sinara-hw/EEM_PWR_MOD_AC/README.md

# EEM_PWR_MOD_AC
80-264V input range AC power module for EEM

## Design Files

Design files (schematics, PCB layouts, BOMs) can be found at [EEM_PWR_MOD_AC/Releases](https://github.com/sinara-hw/EEM_PWR_MOD_AC/releases).

## Wiki

More information can be found on the [wiki](https://github.com/sinara-hw/EEM_PWR_MOD_AC/wiki).
