sinara-hw/EEM_PWR_MOD_AC/(list of files, drawings)

Other design files:
EEM_PWR_MOD_AC.pcbdoc
EEM_PWR_MOD_AC.PrjPCB
EEM_PWR_MOD_AC.SchDoc
Mechanics.SchDoc
