sinara-hw/EEM_PWR_MOD_AC/(threads)

Thread 1 (2020-12-19):

new power module

gkasprow, 2020-12-19:
The time has come! The power module is simple, low cost and robust. It's based on RPS400-12 power module.
I added load indicator (4 LEDs), EMC filter and metal cover.

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

gkasprow, 2020-12-19:
It's modification of the CPCIS version, with other connector, front panel IEC socket and without all management. The mechanics, PCB shape was already verified.

dtcallcock, 2020-12-31:
Can you add pdfs to v1.0rc1 release @gkasprow if you have time?

gkasprow, 2021-01-05:
done

Closed 2021-08-18.

Thread 2 (2020-12-19):

mechanical BOM

gkasprow, 2020-12-19:
Aapart from mechanic components already in the BOM, several  other components are needed:
- two cables connecting power module and the main board. One siede is Molex KK 2.54, the other side is TKP DH2 (4 pin)
- two cables with M3.5 pan HD screw terminals on both ends
- two M3 screws with washer compatible with 7461057 bushings

kaolpr, 2020-12-22:
* EPP-400-12 MEAN WELL

kaolpr, 2020-12-22:
* AC cable connecting power module and the main board, one side is KK 3.96mm Crimp Terminal Housing (mating with Molex 26-62-4030), the other side is JST VHR

gkasprow, 2020-12-23:
JST VHR can be mated with Molex KK3.96

gkasprow, 2021-02-22:
we need two 4-wire cables terminated with DF11-4DS-2C connectors. Contact PN is DF11-22SCA

gkasprow, 2021-05-27:
the 8HP panels require special 0.1" offset handles, [PN 20817-690](https://schroff.nvent.com/en-gb/products/enc20817-690)

gkasprow, 2021-05-27:
...and the 8HP panel must be [special type](https://schroff.nvent.com/en-gb/products/enc30848-430), compatible with the handle: PN is 30848-430

gkasprow, 2021-05-27:
We of course also need a standard set of components to attach the panel to the PCB: angle bracket plastic sleeves, M2.5 screws, etc.

gkasprow, 2021-08-18:
Front panel part number should be 30848-430 (0,1" offset) with handle 20817-682 (0,1" offset).
For rails 24560-359 (0,1" offset).

https://schroff.nvent.com/en-gb/products/plug-unit-u-profile-front-panel-iel-iet-type-2-01-offset/enc30848-430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
https://schroff.nvent.com/en-gb/products/inserterextractor-handle-type-iel-black-01-offset/enc20817-682
https://schroff.nvent.com/en-gb/products/guide-rail-coding-compactpci-vme64x-offset-01/enc24560-359

Thread 4 (2020-12-30):

Front panel offset

jakgajewski, 2020-12-30:
Front panel part number should be 30848-430 (0,1" offset) with handle 20817-682 (0,1" offset).
For rails 24560-359 (0,1" offset).

https://schroff.nvent.com/en-gb/products/plug-unit-u-profile-front-panel-iel-iet-type-2-01-offset/enc30848-430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
https://schroff.nvent.com/en-gb/products/inserterextractor-handle-type-iel-black-01-offset/enc20817-682
https://schroff.nvent.com/en-gb/products/guide-rail-coding-compactpci-vme64x-offset-01/enc24560-359

jakgajewski, 2020-12-30:
Additionally, only two M3 nuts are required for mechanics assembly

gkasprow, 2021-02-22:
fixed

Closed 2021-08-18.

Thread 5 (2021-01-05):

R4

dtcallcock, 2021-01-05:
What's the purpose of this? Won't it lead to the P5V0SB rail being significantly less than 5V?

dtcallcock, 2021-01-05:
Never mind, figured it out.

Closed 2021-08-18.

Thread 6 (2021-01-08):

mechanical issues

gkasprow, 2021-01-08:
move the press-fit contact by 1cm
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

Closed 2021-08-18.

Thread 7 (2021-02-23):

photos

gkasprow, 2021-02-23:
The module is working. There were problems with current measurement and connector collisions but they were resolved. Here are some photos.
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

Closed 2021-08-18.

Thread 8 (2021-02-26):

PE and GND

kaolpr, 2021-02-26:
Is it OK to connect PE directly to GND that is used by all powered modules? Shouldn't it be connected to front panel and casing only?

gkasprow, 2021-02-26:
Right. It should be connected to the chassis to make isolation possible to avoid ground loops.

gkasprow, 2021-08-18:
fixed; added DNP 0805 resistor that shorts PE with GND

Closed 2021-08-18.

Thread 10 (2021-06-25):

Change J3 part

kaolpr, 2021-06-25:
Currently J3 (AC connector for EPP-400) is of type MOLEX_26-62-4030 which is different from the one on the EPP-400. Maybe we could change it to AMP-TE  1-1123723-3 (JST suggested in EPP datasheet is hardly available)  that cable can have the same plugs on both ends?

gkasprow, 2021-08-18:
OK, replaced with JST one which is available from Farnell

gkasprow, 2021-08-18:
I added also comment that can AMP-TE 1-1123723-3 can be used instead

Closed 2021-08-18.

Thread 9 (2021-06-25):

Mechanical design

kaolpr, 2021-06-25:
After assembling 2 units I have to say that mechanical design of PCB and housing **needs** to be changed:

1. The cutout for the power module is too small  and PCB sometimes collides with a heatsink. Seems to be dependent on the particular MW module, had to choose one that will fit. Nevertheless, there should be some margin to accommodate for assembly tolerances.

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

2. There is not enough space for 12V / GND cabling. Though it *can be done*, it's very time consuming and cables must be fitted between power module elements.

Suggest extending PCB by 15 mm and exchanging connectors to straight. This will not take more space then current solution and will give a lot more room for cabling. MOLEX_39-28-1043 (straight one) with plug connected has height of 23.6 mm, whereas available height to the adjacent module plane is ~35 mm, so for bending power cable we would have ~10mm.

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

We could also extend cutout easily and, after extending case (red line), also power buds would be covered:

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

gkasprow, 2021-06-25:
Make sure that vertical plugs fit within 8HP

kaolpr, 2021-07-02:
Well, I tried, and it looks OK, though not very elegant. Alternatively we can keep angled connectors accepting the fact that the module will be longer by 15mm.

kaolpr, 2021-07-06:
Well, it will be a bit cramped... I have some doubts on whether it will be possible to bend those cables when first module after PSU will be replaced (without removing back cover and adjusting them by hand). Thus, I'd opt for keeping angled connectors and extending module length by 15mm.

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

gkasprow, 2021-07-07:
let's make it longer.

gkasprow, 2021-08-18:
fixed
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

Closed 2021-08-18.

Thread 11 (2023-07-19):

Screws outside clearance

jordens, 2023-07-19:
The four screws that attach the PCB underside cover to the upper cover (two are visible at https://user-images.githubusercontent.com/4325054/108885730-6f0ef800-7608-11eb-81cf-571b436ed6ca.jpg) interfere with guide rails of module storage systems.
If possible the covers should be changed to be narrower, or the screws should be moved (attach front and back instead of on the sides), or the screws should be made flatter.

gkasprow, 2023-07-19:
The scews should be countersunk type (I think they are) and the shield should have chamfered holes.

jordens, 2023-07-20:
I got black round top screws, not countersunk. And the sheet metal didn't have any visible chamfering. If the BOM and mechanical designs are already clear, complete, and correct here we can close this as manufacturing deviation.

gkasprow, 2023-07-20:
@pkozakiewicz ?

pkozakiewicz, 2023-07-20:
I do not recognize the device in Robert's picture as ours have black powder painted cover. This one has also FDM printed front panel (?). I am pretty sure that we overcame this in the newest revision.

I see no collision with guide rail in our case and we do not use countersunk holes. Please see a picture. We used our v1.2 PSUs in multiple setups and it was never an issue.
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

jordens, 2023-07-20:
Those are not countersunk screws and the covers are not chamfered.
The screws touch the rail even in a normal crate. In board storage systems there is always the next board guide adjacent and the screws interfere with them.

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

pkozakiewicz, 2023-07-21:
I see. The metal sheet may be be too thin to apply countersunk holes (0.85 mm incl. powder coating). As a temporary solution we will look for screws with lower head as the one used is >2 mm.

In the next revision cutouts in the PCB outline should be enlarged to make room for embossing in the cover in order to hide the screws.

jordens, 2023-07-21:
Oh yes. Embossing is a nice solution here assuming there is space behind!

pkozakiewicz, 2023-07-21:
There are no obstacles behind current screw positions that would prevent us from doing this, but the size of PSU module itself makes the design difficult to assemble. It would be good to save some space by replacing it with some alternative with a more compact design.

Closed 2023-10-18.

Thread 12 (2023-11-30):

Offset

jordens, 2023-11-30:
In #4 the panel was made to be offset by 0.1". For cPCI this makes sense to enforce early mechanical incompatibility due to the backplane and the connectors in the back.
But this module is not cPCI at all, it is "legacy" EEM style, where there is no backplane and no meaningful difference between slots in the rack.
Can we go back to the non-offset panel?

Or is the reason the thicker population on the board underside with the cover? Could one then not go for a thinner design with the open frame supply shifted to the right (0.1" larger stand-offs), and using e.g. Schroff 61000-177 to cover the underside?

jordens, 2024-11-08:
In the same sense, the cPCI handle doesn't make sense as there is no backplane to press into/pull out from. It gives a false sense of hot-pluggability.

gkasprow, 2024-11-08:
DIOT uses cpcis power modules so the backplane connector is already offset by 0.1"
0.1" is needed to properly isolate mains part on the bottom of the power module.
There are four kinds of CPCIS handles - with offset and without it, with switch and without it.
The lever is usefull because we need much more force to pluf/unplug module from backplane.

Thread 13 (2023-12-13):

Protruding screws

jordens, 2023-12-13:
The four screws of the cover standoffs protrude (in some cases 1 mm) through the nut that is pressed/welded into the top cover (right side when placed in the crate).
This makes the module wider than its front panel.
Since there is very little space between that top cover and the underside parts of the adjacent (right) module, this is can touch and cause damage on insertion/shorts.

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

gkasprow, 2023-12-13:
In the protype and design we used countersunk screws

jordens, 2023-12-13:
Which ones?

I meant the screw of the standoff protruding through the cover. The one that's just adjacent to the sticker.

gkasprow, 2023-12-13:
oh, there are just inserts. They should be completely flat with no protruding screws. It llooks TS used too long screws.

pkozakiewicz, 2023-12-15:
@jordens Thank you for bringing it to our attention. There are no screws there just threaded spacers. We haven't found such elements with shorter thread anywhere and the design does not let us use a shorter spacer. The reasonable way seems to be to grind two turns of the thread.  We already solved this in v1.3.

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

Thread 14 (2024-11-08):

DIOT power module

jordens, 2024-11-08:
One could design a custom power module for DIOT with the following features:

* 220mm depth, 8HP wide, offset green rails like EEM_PWR_MOD_AC
* FCI power blade directly into the DIOT backplane connector (inverted, on the PCB bottom, mechanics and pinout as on the existing jumper DIOT front interface PCBA)
* 230V connector on the front panel like EEM_PWR_MOD_AC and CPCIS-AC-PSU
* Could also house the 2 DSUB 15 connectors, ESD plug and RST BNC + relay like the DIOT front interface (and maybe a power switch)
* Could also include the I2C PSU monitoring circuitry
* This would replace the DIOT power backplane, the DIOT front interface, the custom short rails, the custom rail stabilizing mechanics, and the rear mains inputs
* The full DIOT crate would fit into 63 HP, no custom mechanical parts required. The latter may make it worthwhile even in a 84 HP crate.
* This amounts to putting CPCIS-AC-PSU circuitry onto the DIOT front interface board
* It would need a 9HP panel to cover the remaining 1 HP between the 8th peripheral and the PSU
* Presumably, inserting/removing the PSU would require removing the last peripheral (FCI conector collision)

gkasprow, 2024-11-08:
Similar low cost module was already designed
https://github.com/elhep/CPCIS-AC-PSU/issues/5
It needs only bottom cover and some cap around the mains fuses
I paid ~200EUR/pc at AISLER
We already got rid of all rear modules
The DIOT front interface will be modifed to also host the 1ppm reference source distributed to boards that would benefit from it like Fastino

jordens, 2024-11-08:
I know, that's why I referenced it above.

About the voltage reference I wonder how you want to tackle the thermocouple voltages at the connectors. Aren't they typically much more than 10 uV in a thermally busy crate?

gkasprow, 2024-11-10:
Let's go this way. AC PSU design is very complex mechanically so I'd go with 3 or even 4x 90W Meanwell converters

jordens, 2024-11-10:
Isn't there plenty of space on 3U/9HP/220mm for a LOP-400-12 or EPP-400-12 plus all the circuitry mentioned above?

gkasprow, 2024-11-10:
I've just noticed that we have a 9HP panel and don't use a 0.1" offset. That means we can install LOP-400-12 and some protective cover on top of the bare PCB to protect from the bottom side.

gkasprow, 2024-11-10:
There are 9 HP panels [available](https://schroff.nvent.com/en-in/products/enc30848-299) but only for IET Type 2 Handle

gkasprow, 2024-11-10:
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

gkasprow, 2024-11-10:
we won't fit LOP-400-12 within 6HP panel without excessive mechanical complexity

jordens, 2024-11-10:
It's a 0.2" offset as for the DIOT front interface.

Then for a 84 HP crate you'd want 10HP (same panel as the DIOT front interface) to avoid the need for another odd filler panel.
I think 9HP for a 63HP crate would be ideal. But the 63 HP crate does seem a bit exotic.

gkasprow, 2024-12-24:
Let's add a few standard Molex 12V connectors. That would be nice to supply non-Kasli boards like Stabilizer in the same crate

gkasprow, 2024-12-24:
Maybe we should also integrate some fan management. The chassis I use has 3 nice radial fans on top but they are noisy. We could place sth like MAX31740 plus I2C logics that can take over and control the fan speed in more robust way by SW.

jordens, 2024-12-24:
Maybe better and easier (less development baggage) to mount the diot fan controller as a small piggy back board and keep full electrical compatibility to the diot fan tray.

Thread 15 (2024-11-10):

wrong airflow direction

jordens, 2024-11-10:
Currently:

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

vs datasheet:

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

Thread 17 (2025-04-10):

Proposal to switch to the LOP-400 power supply

gravelpitman, 2025-04-10:
Using the EPP-400 power supply, we have very little space, and we use a strange arrangement of components in the module (the power supply is flipped upside down). The enclosure barely fits within the 8HP dimensions. If we used a Low Profile power supply, we could arrange it in a normal position and reduce the size of the enclosure a bit
However, the question arises here whether we still want to produce this type of power supply, or if we are completely switching to DIPSU?

jordens, 2025-04-10:
I suspect it would be cost-effective to use DIPSU even for the classic EEM crates with an adapter PCB from Amphenol FCI to Molex.

gravelpitman, 2025-04-11:
Implementing this solution will cost us 2HP of space on the module's left side (viewed from the crate front) due to the Amphenol FCI connector located on the board's bottom layer.

jordens, 2025-04-11:
But dipsu is longer than any Sinara card. That connector doesn't collide with anything. To recover the remaining 1hp you want a standard non-offset 8HP panel. That's preferred anyway as outlined in #12 .

jordens, 2025-04-11:
You can also mount an array of goldpins on PCB top instead of the fci connector on PCB bottom. Then adapter to Molex there using the fci mounting holes to attach.
